jmthompson/cole-1/README.md

COLE-1+
=======

This repository contains the schematics, board layouts, GAL code, and firmware
for the COLE-1 and COLE-1+ single-board computers.

The current HEAD of htis repository represents COLE-1+. To retrieve the files
for the older COLE-1, check out the v1.0 tag.
