jmthompson/cole-1/hardware/cole-1.kicad_pcb

## KiCad design hardware/cole-1.kicad_pcb (2021-08-12)

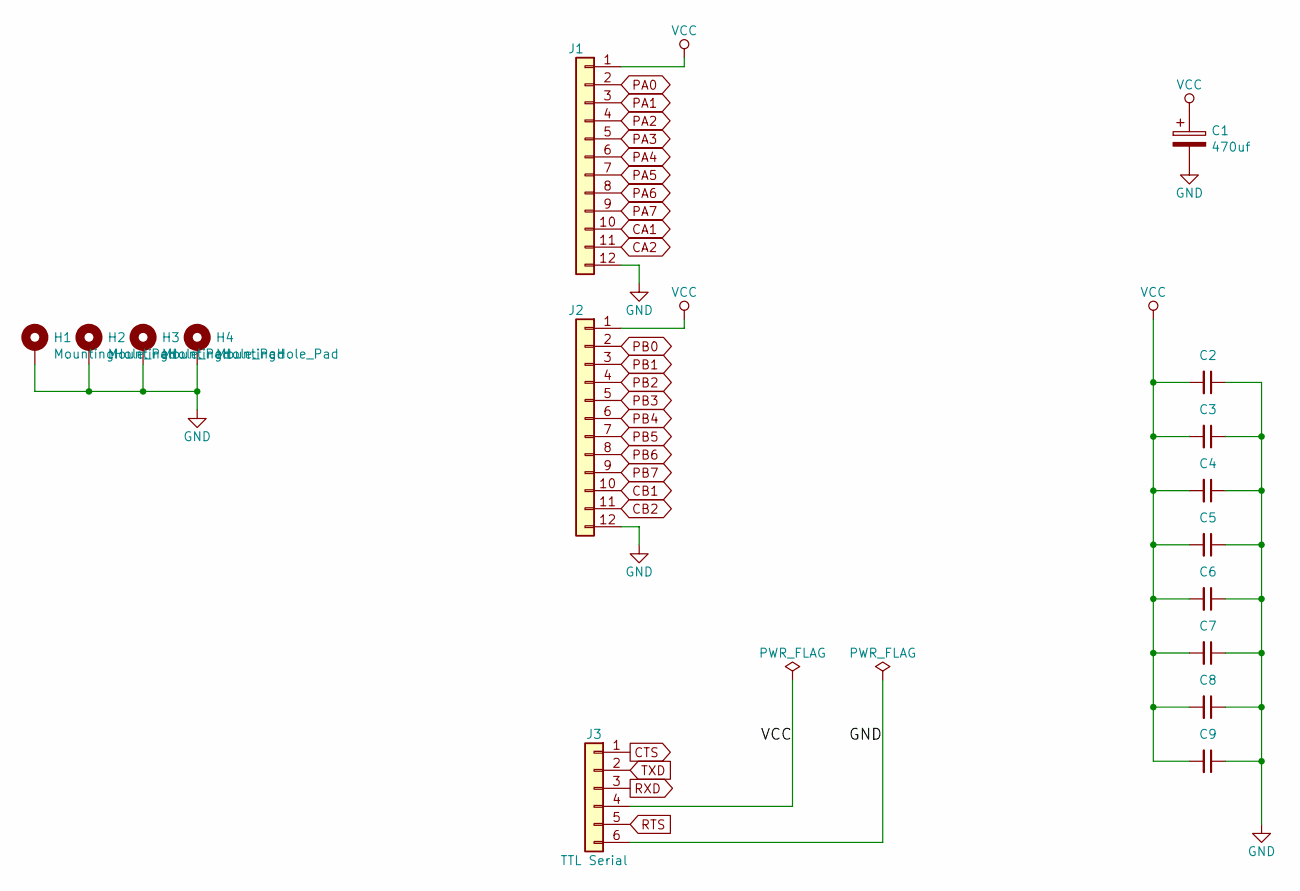
[picture p1: schematic cole-1-caps.sch, COLE-1+ I/O Ports & Decoupling Capacitors]

Parts:
C1: 470uf; CP_Radial_D13.0mm_P7.50mm
C2, C3, C4, C5, C6, C7, C8, C9: 0.1u; C_0805_2012Metric_Pad1.15x1.40mm_HandSolder
H1, H2, H3, H4: MountingHole_Pad; MountingHole_2.5mm_Pad_Via
J1: PORT A; PinHeader_1x12_P2.54mm_Vertical
J2: PORT B; PinHeader_1x12_P2.54mm_Vertical
J3: TTL Serial; PinHeader_1x06_P2.54mm_Vertical

Connections:
CA1: J1.10; also elsewhere on the board
CA2: J1.11; also elsewhere on the board
CB1: J2.10; also elsewhere on the board
CB2: J2.11; also elsewhere on the board
CTS: J3.1; also elsewhere on the board
GND: C1.2, C2.1, C3.1, C4.1, C5.1, C6.1, C7.1, C8.1, C9.1, H1.1, H2.1, H3.1, H4.1, J1.12, J2.12, J3.6; also elsewhere on the board
PA0: J1.2; also elsewhere on the board
PA1: J1.3; also elsewhere on the board
PA2: J1.4; also elsewhere on the board
PA3: J1.5; also elsewhere on the board
PA4: J1.6; also elsewhere on the board
PA5: J1.7; also elsewhere on the board
PA6: J1.8; also elsewhere on the board
PA7: J1.9; also elsewhere on the board
PB0: J2.2; also elsewhere on the board
PB1: J2.3; also elsewhere on the board
PB2: J2.4; also elsewhere on the board
PB3: J2.5; also elsewhere on the board
PB4: J2.6; also elsewhere on the board
PB5: J2.7; also elsewhere on the board
PB6: J2.8; also elsewhere on the board
PB7: J2.9; also elsewhere on the board
RTS: J3.5; also elsewhere on the board
RXD: J3.3; also elsewhere on the board
TXD: J3.2; also elsewhere on the board
VCC: C1.1, C2.2, C3.2, C4.2, C5.2, C6.2, C7.2, C8.2, C9.2, J1.1, J2.1, J3.4; also elsewhere on the board

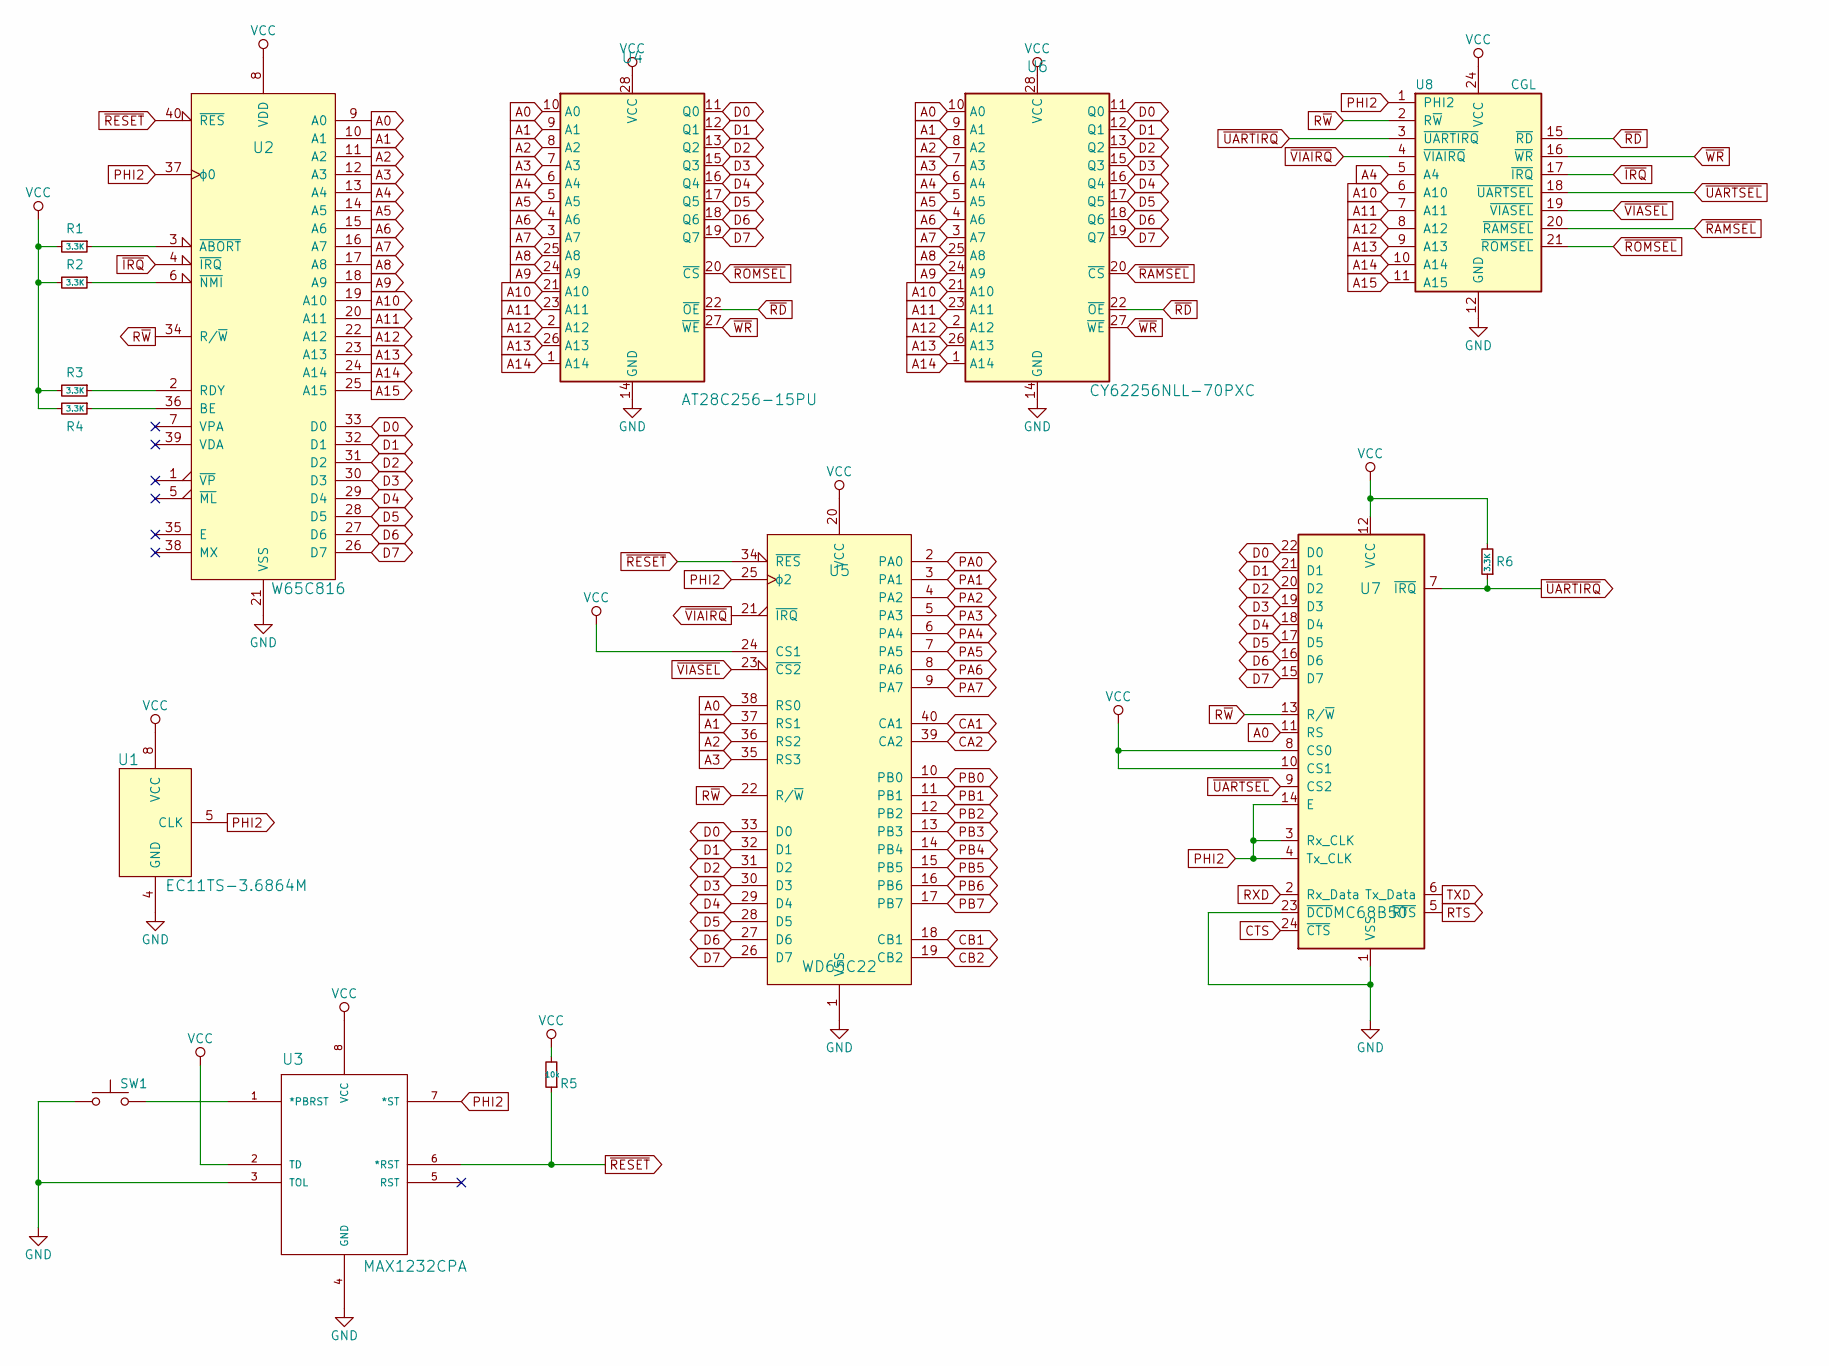
[picture p2: schematic cole-1-core.sch, COLE-1+ Main Logic]

Parts:
R1, R2, R3, R4, R6: 3.3K; R_0805_2012Metric_Pad1.15x1.40mm_HandSolder
R5: 10k; R_0805_2012Metric_Pad1.15x1.40mm_HandSolder
SW1: SW_Push; SW_PUSH_6mm_H5mm
U1: EC11TS-3.6864M; DIP-8_W7.62mm_Socket
U2: W65C816; DIP-40_W15.24mm_Socket
U3: MAX1232CPA; DIP-8_W7.62mm_Socket
U4: AT28C256-15PU; DIP-28_W15.24mm_Socket
U5: WD65C22; DIP-40_W15.24mm_Socket
U6: CY62256NLL-70PXC; DIP-28_W15.24mm_Socket
U7: MC68B50; DIP-24_W15.24mm_Socket
U8: CGL; DIP-24_W7.62mm_Socket

Connections:
A0: U2.9 (A0), U4.10 (A0), U5.38 (RS0), U6.10 (A0), U7.11 (RS)
A1: U2.10 (A1), U4.9 (A1), U5.37 (RS1), U6.9 (A1)
A2: U2.11 (A2), U4.8 (A2), U5.36 (RS2), U6.8 (A2)
A3: U2.12 (A3), U4.7 (A3), U5.35 (RS3), U6.7 (A3)
A4: U2.13 (A4), U4.6 (A4), U6.6 (A4), U8.5 (A4)
A5: U2.14 (A5), U4.5 (A5), U6.5 (A5)
A6: U2.15 (A6), U4.4 (A6), U6.4 (A6)
A7: U2.16 (A7), U4.3 (A7), U6.3 (A7)
A8: U2.17 (A8), U4.25 (A8), U6.25 (A8)
A9: U2.18 (A9), U4.24 (A9), U6.24 (A9)
A10: U2.19 (A10), U4.21 (A10), U6.21 (A10), U8.6 (A10)
A11: U2.20 (A11), U4.23 (A11), U6.23 (A11), U8.7 (A11)
A12: U2.22 (A12), U4.2 (A12), U6.2 (A12), U8.8 (A12)
A13: U2.23 (A13), U4.26 (A13), U6.26 (A13), U8.9 (A13)
A14: U2.24 (A14), U4.1 (A14), U6.1 (A14), U8.10 (A14)
A15: U2.25 (A15), U8.11 (A15)
CA1: U5.40 (CA1); also elsewhere on the board
CA2: U5.39 (CA2); also elsewhere on the board
CB1: U5.18 (CB1); also elsewhere on the board
CB2: U5.19 (CB2); also elsewhere on the board
CTS: U7.24 (~CTS); also elsewhere on the board
D0: U2.33 (D0), U4.11 (Q0), U5.33 (D0), U6.11 (Q0), U7.22 (D0)
D1: U2.32 (D1), U4.12 (Q1), U5.32 (D1), U6.12 (Q1), U7.21 (D1)
D2: U2.31 (D2), U4.13 (Q2), U5.31 (D2), U6.13 (Q2), U7.20 (D2)
D3: U2.30 (D3), U4.15 (Q3), U5.30 (D3), U6.15 (Q3), U7.19 (D3)
D4: U2.29 (D4), U4.16 (Q4), U5.29 (D4), U6.16 (Q4), U7.18 (D4)
D5: U2.28 (D5), U4.17 (Q5), U5.28 (D5), U6.17 (Q5), U7.17 (D5)
D6: U2.27 (D6), U4.18 (Q6), U5.27 (D6), U6.18 (Q6), U7.16 (D6)
D7: U2.26 (D7), U4.19 (Q7), U5.26 (D7), U6.19 (Q7), U7.15 (D7)
GND: SW1.1, U1.4 (GND), U2.21 (VSS), U3.3 (TOL), U3.4 (GND), U4.14 (GND), U5.1 (VSS), U6.14 (GND), U7.1 (VSS), U7.23 (~DCD), U8.12 (GND); also elsewhere on the board
unnamed: R1.1, U2.3 (~ABORT)
unnamed: R2.1, U2.6 (~NMI)
unnamed: R3.1, U2.2 (RDY)
unnamed: R4.1, U2.36 (BE)
unnamed: SW1.2, U3.1 (*PBRST)
PA0: U5.2 (PA0); also elsewhere on the board
PA1: U5.3 (PA1); also elsewhere on the board
PA2: U5.4 (PA2); also elsewhere on the board
PA3: U5.5 (PA3); also elsewhere on the board
PA4: U5.6 (PA4); also elsewhere on the board
PA5: U5.7 (PA5); also elsewhere on the board
PA6: U5.8 (PA6); also elsewhere on the board
PA7: U5.9 (PA7); also elsewhere on the board
PB0: U5.10 (PB0); also elsewhere on the board
PB1: U5.11 (PB1); also elsewhere on the board
PB2: U5.12 (PB2); also elsewhere on the board
PB3: U5.13 (PB3); also elsewhere on the board
PB4: U5.14 (PB4); also elsewhere on the board
PB5: U5.15 (PB5); also elsewhere on the board
PB6: U5.16 (PB6); also elsewhere on the board
PB7: U5.17 (PB7); also elsewhere on the board
PHI2: U1.5 (CLK), U2.37 (ϕ0), U3.7 (*ST), U5.25 (ϕ2), U7.3 (Rx_CLK), U7.4 (Tx_CLK), U7.14 (E), U8.1 (PHI2)
RTS: U7.5 (~RTS); also elsewhere on the board
RXD: U7.2 (Rx_Data); also elsewhere on the board
R~W: U2.34 (R/~W), U5.22 (R/~W), U7.13 (R/~W), U8.2 (R~W)
TXD: U7.6 (Tx_Data); also elsewhere on the board
VCC: R1.2, R2.2, R3.2, R4.2, R5.2, R6.2, U1.8 (VCC), U2.8 (VDD), U3.2 (TD), U3.8 (VCC), U4.28 (VCC), U5.20 (VCC), U5.24 (CS1), U6.28 (VCC), U7.8 (CS0), U7.10 (CS1), U7.12 (VCC), U8.24 (VCC); also elsewhere on the board
~IRQ: U2.4 (~IRQ), U8.17 (~IRQ)
~RAMSEL: U6.20 (~CS), U8.20 (~RAMSEL)
~RD: U4.22 (~OE), U6.22 (~OE), U8.15 (~RD)
~RESET: R5.1, U2.40 (~RES), U3.6 (*RST), U5.34 (~RES)
~ROMSEL: U4.20 (~CS), U8.21 (~ROMSEL)
~UARTIRQ: R6.1, U7.7 (~IRQ), U8.3 (~UARTIRQ)
~UARTSEL: U7.9 (CS2), U8.18 (~UARTSEL)
~VIAIRQ: U5.21 (~IRQ), U8.4 (~VIAIRQ)
~VIASEL: U5.23 (~CS2), U8.19 (~VIASEL)
~WR: U4.27 (~WE), U6.27 (~WE), U8.16 (~WR)

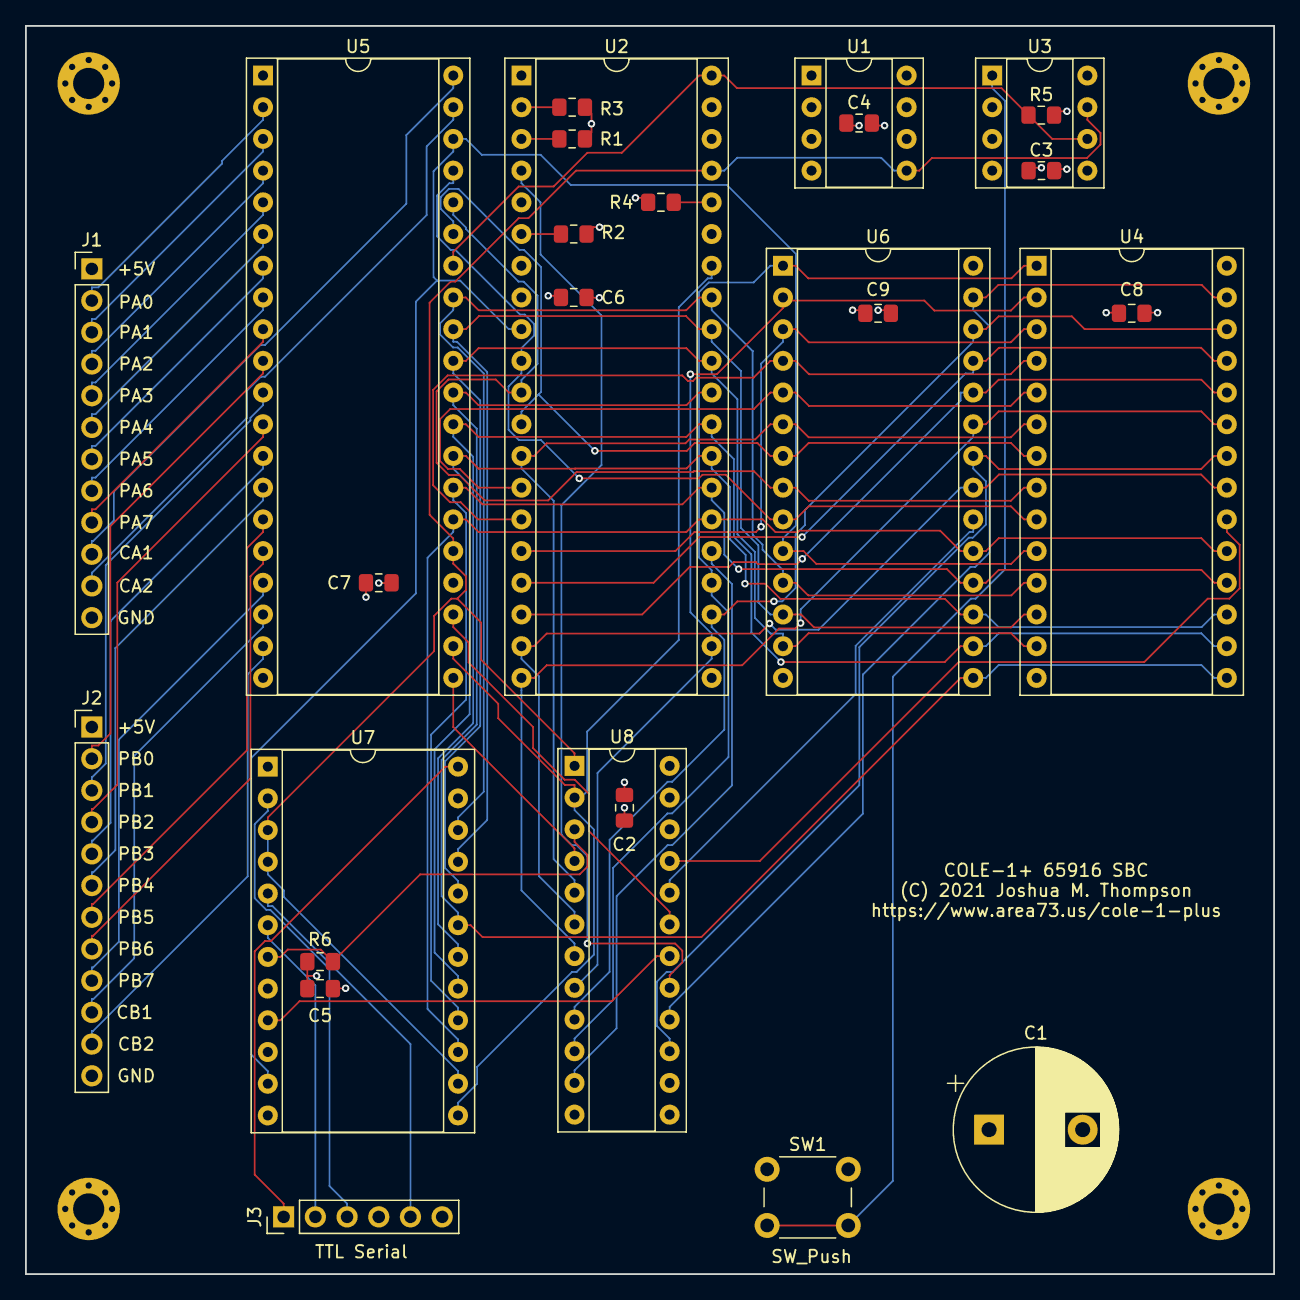
[picture p3: board cole-1.kicad_pcb from above]

Board: 4 copper layers, 100.0 x 100.0 mm, 31 parts (0 on the bottom side), 67 nets.
