jmthompson/cole-1/(commit log)

2018-01-04 Move the LED flash back to the right spot
2018-01-04 Split fw.s into osentry.s and vectors.s, and rame ld65 config file from fw.cfg to cole-1.cfg.
    [cole-1.cfg]
2018-01-08 Added a monitor program now, currently only handles BRKs and memory dump commands Added support for the console to not be serial, by having all ROM code do its I/O via the new console_read an console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
    [cole-1.cfg]
2018-01-08 - Change WE on the EEPROM to be tied to ground, like it is on the breadboard prototype. - Change TD pin on the MAX1232 to bre tied to Vcc, which raises the watchdog timeout to 1.2s. - Add Vcc and GND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
    [cole-1-caps.sch, cole-1-core.sch, cole-1-decoding.sch, cole-1-io.sch]
2018-01-13 change VIA port connectors to 2x12 connectors with per-signal ground wires
    [cole-1-caps.sch, cole-1-io.sch]
2018-01-13 switch to a DIP-8 oscillator, and fix footprint for MAX1232
    [cole-1-core.sch]
2018-01-14 Final schematic and PCB layout.
    [cole-1-caps.sch, cole-1-core.sch, cole-1-decoding.sch, cole-1-io.sch, cole-1.kicad_pcb, cole-1.sch]
2018-01-14 - document the memory map (finally!) - monitor now has working memory dump and run commands - removed watchdog code since it's now hard-wired to Phi2 - initial skeletal implementation of SPI on VIA p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
    [cole-1.cfg]
2018-01-14 - Add a generated version.s file that defines a rom_version symbol containing the current ROM version as a date string - Change boot banner display to use the rom_version string instead of the hard-c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
    [cole-1.cfg]
2018-01-15 add XModem-CRC send/receive code, and add 'r' monitor command to accept xmodem uploads to a location in memory
    [cole-1.cfg]
2018-06-02 fix footprint for the ACIA
    [cole-1-io.sch]
2018-06-02 Update PHI2 to reflect final hardare at 4 MHz, change SPI device select devices via 74HC138, and add bug fixes to make SPI functional
2018-06-02 Misc bug fixes in writeln, optimized print_hex_digit, and added initial JEROS hook.
2019-03-04 Final commit
    [cole-1-2018-07-31-19-32-09.sch, cole-1-2018-07-31-19-59-57.sch, cole-1-caps-2018-07-31-19-32-09.sch, cole-1-caps-2018-07-31-19-59-57.sch, cole-1-core-2018-07-31-19-32-09.sch, cole-1-core-2018-07-31-19-59-57.sch, cole-1-decoding-2018-07-31-19-32-09.sch, cole-1-decoding-2018-07-31-19-59-57.sch]
2021-08-10 Updated schematics, board layout, and GAL code for COLE-1+
    [cole-1-caps.sch, cole-1-core.sch, cole-1-decoding.sch, cole-1-io.sch, cole-1.kicad_pcb, cole-1.sch]
2021-08-12 Add A10 and A11 routing to GAL, and update GAL equations
    [cole-1-core.sch, cole-1.kicad_pcb]
2021-08-19 Replace firmware with modified COLE-2 firmware
    [cole-1.cfg]
2021-08-20 Update memory_map.txt to reflect new RAM layout Change monitor run command from "r" to "g" to match Apple II monitor Add code to disassembler to track M/X flags
2021-08-22 Memory map layout change: LOWROM is now BOOTROM at $F000; HIGHROM is now BIOSROM at $9000.
    Reduced ROM size by 2k so that a copy of it can fit entirely in the user RAM area.
    Added a utility for flashing the ROM via Xmodem upload
    [cole-1.cfg]
