jmthompson/cole-1/(notices)

Notices in the files:
hardware/cole-1.kicad_pcb:
(C) 2021 Joshua M. Thompson
